Cytrill/hrdwr/3dprint-case/pic2.jpg

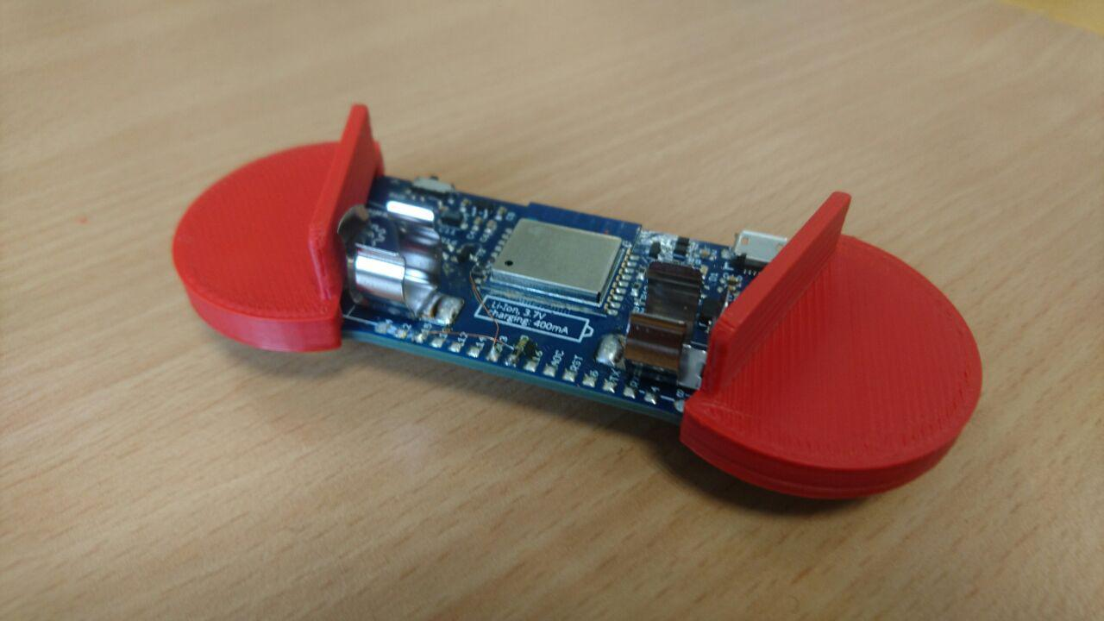
3dprint-case/pic2.jpg
