Cytrill/hrdwr/3dprint-case/pic1.jpg

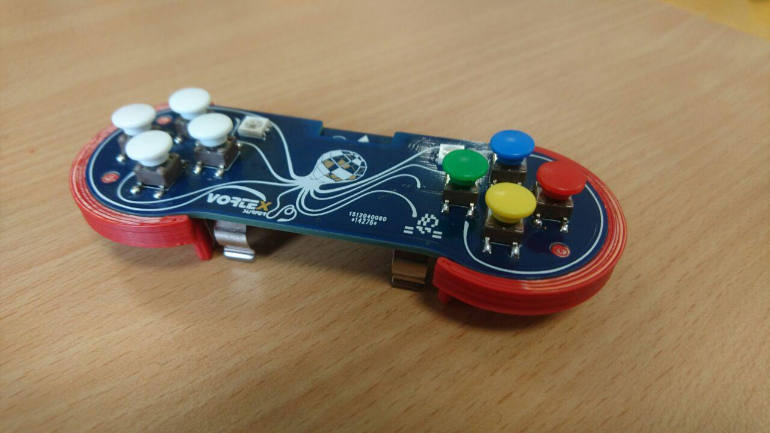
3dprint-case/pic1.jpg
