Cytrill/hrdwr/3dprint-case/readme.md

# 3D printable minimal case for Cytrill

Two 3d printable snap-on-grips. Print with the top side down and turn on support. Tested with Filamentum Extrafill ASA and works quite well after removing the support structures.

Developed in Onshape. Here is the public link (you do need a free Onshape account): https://cad.onshape.com/documents/3a4faa39f6ada6678b01b857/w/6fd7777d908e56194de24522/e/34ffa1ef84f45b661b3a6077
