Cytrill/hrdwr/3dprint-case/cytrillcase_bothhalves.stl

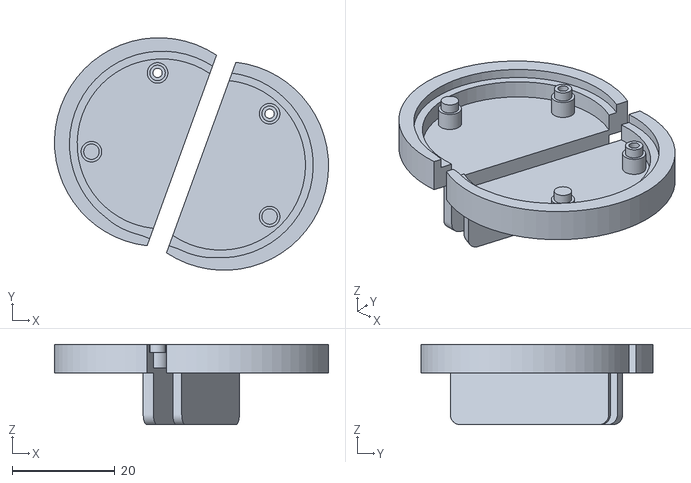
[picture p3: CAD file, 2016-03-09]
3dprint-case/cytrillcase_bothhalves.stl
53.2 x 45.1 x 15.6
