Cytrill/hrdwr/(list of files, cad)

Other CAD files:
blender-files/mockup.blend
