Cytrill/hrdwr/eagle-files/Cytrill.brd

## EAGLE design eagle-files/Cytrill.brd (2016-07-04)

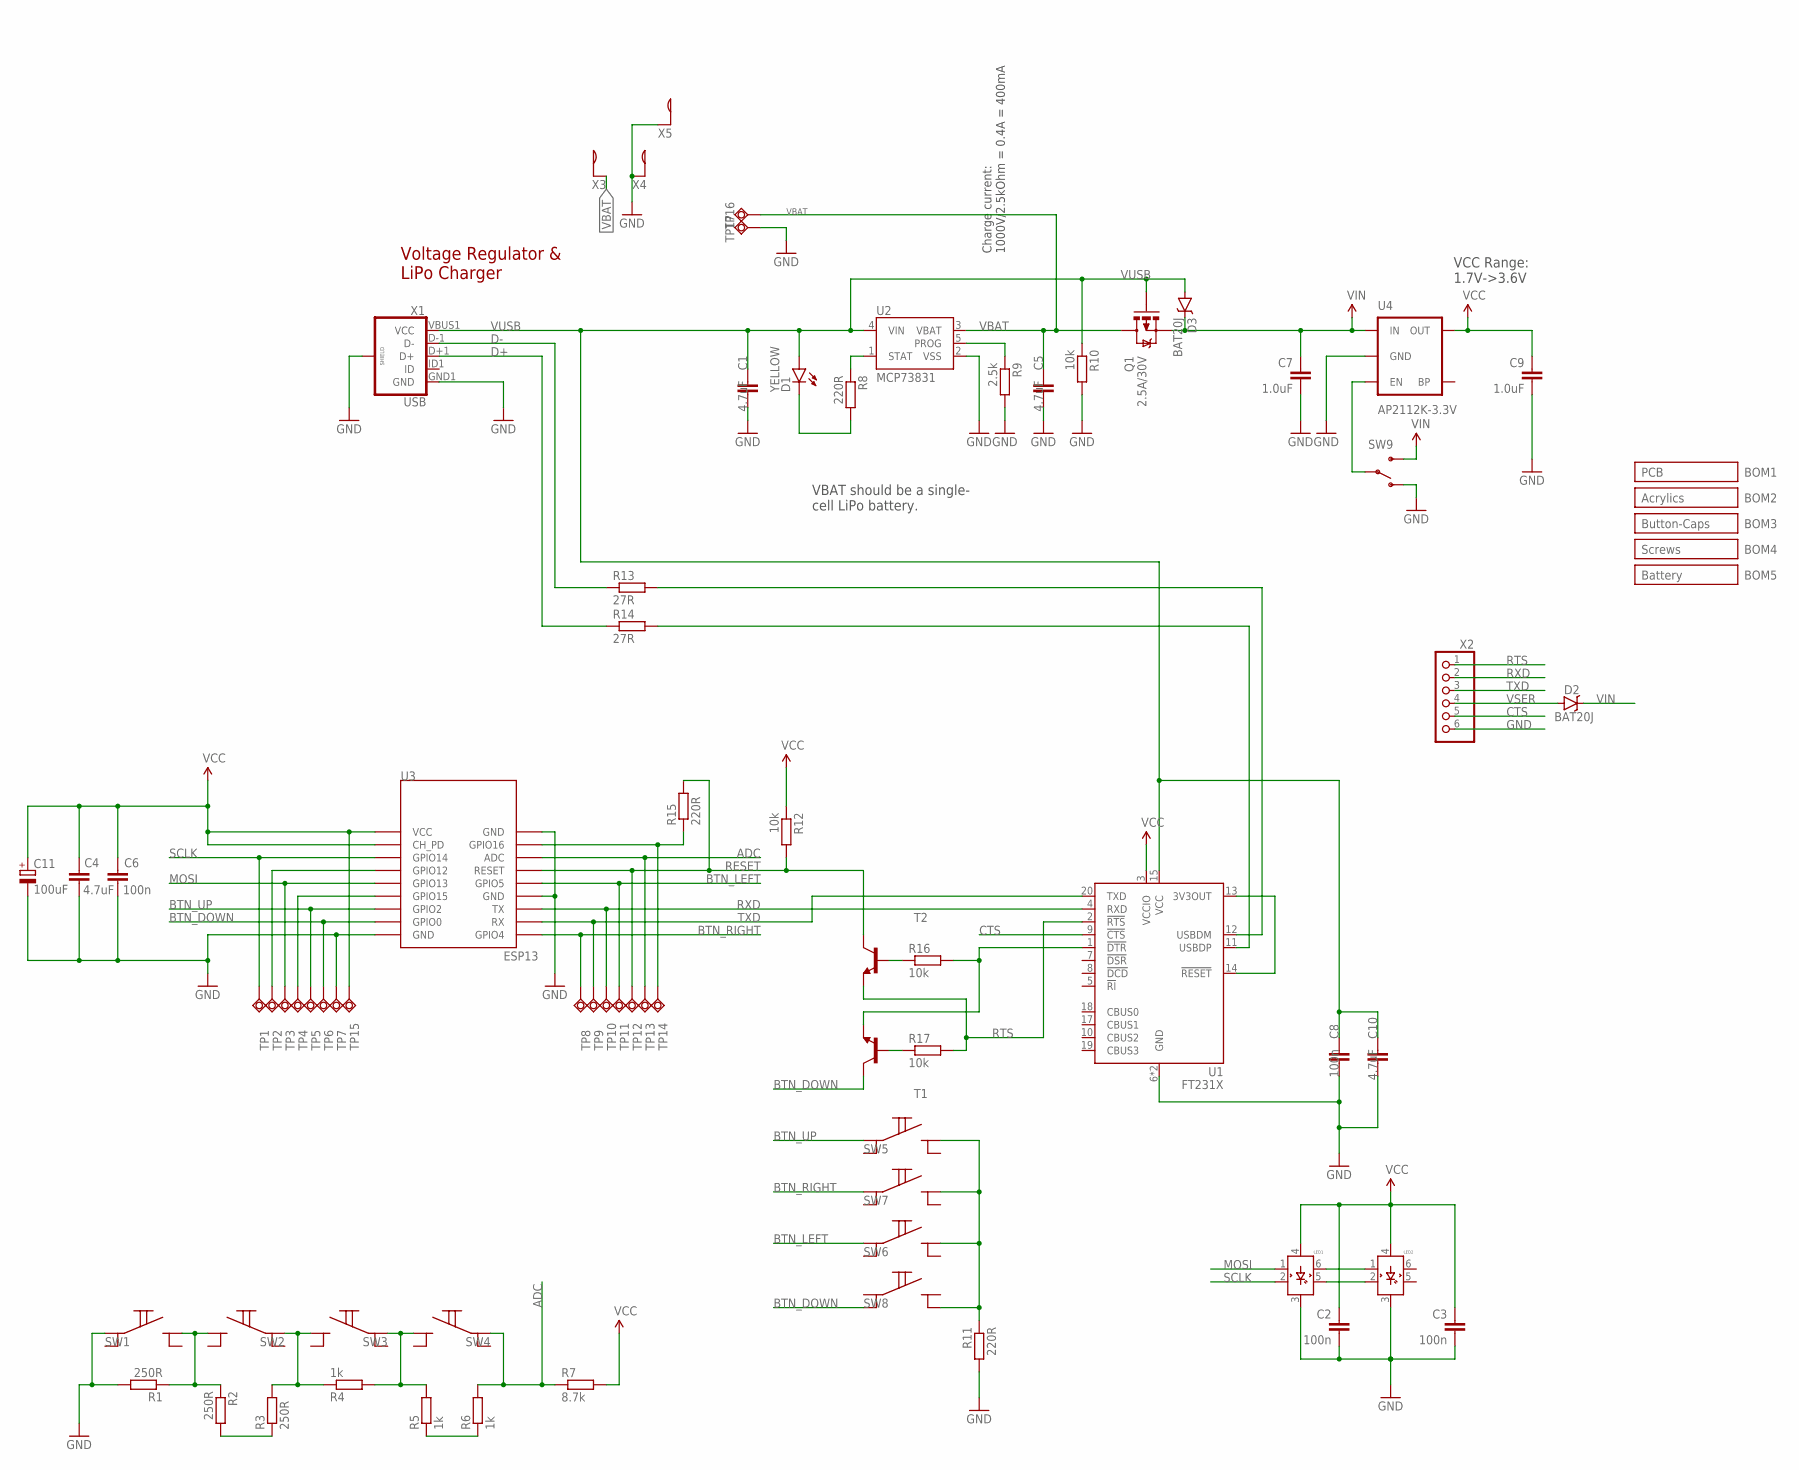
[picture p4: schematic Cytrill.sch]

Parts:
C1, C4, C5, C10: 4.7uF; C0603; PARTNO GRM188R61A475KE15D-MO
C2, C3, C6, C8: 100n; C0603; PARTNO C0603C104K4RACTU-MO
C7, C9: 1.0uF; C0603; PARTNO GRM188R61E105KA12D-MO
C11: 100uF; 3216-A; PARTNO TANTAL100UF
D1: YELLOW; LED-0603; PARTNO LYQ396P1Q236-MO
D2, D3: BAT20J; SOD-323; PARTNO BAT20JFILM-MO
LED1, LED2: APA102; RGBLED5050; PARTNO APA102
Q1: 2.5A/30V; SOT23-3; PARTNO DMP3130L-7-MO
R1, R2, R3: 250R; R0603; PARTNO ERJ3EKF2490V-MO
R4, R5, R6: 1k; R0603; PARTNO ERJ3EKF1001V-MO
R7: 8.7k; R0603; PARTNO ERJ3EKF8661V-MO
R8, R11, R15: 220R; R0603; PARTNO ERJ3EKF2200V-MO
R9: 2.5k; R0603; PARTNO ERJ3EKF2491V-MO
R10, R12, R16, R17: 10k; R0603; PARTNO ERJ3EKF1002V-MO
R13, R14: 27R; R0603; PARTNO ERJ3EKF27R0V-MO
SW1, SW2, SW3, SW4, SW5, SW6, SW7, SW8: TACTSWITCH6MM; TACTSWITCH; PARTNO 101-0364-EV-MO
SW9: SWITCH-SPDT-SMD-A; SWITCH-SPST-SMD-A; PARTNO SSSS810701
T1, T2: BC847C-NPN-SOT23-BEC; SOT23-BEC; PARTNO BC847C-MO
TP1, TP2, TP3, TP4, TP5, TP6, TP7, TP8, TP9, TP10, TP11, TP12, TP13, TP14, TP15: TPSQTP15SQ; TP15SQ; PARTNO TESTPAD
TP16, TP17: TPSQTP20R; TP20R; PARTNO TESTPAD
U1: FT231X; SSOP20; PARTNO FT231XS
U2: MCP73831; SOT23-5; PARTNO MCP73831T-2ATI/OT
U3: ESP13; PARTNO esp-13
U4: AP2112K-3.3V; SOT23-5; PARTNO AP2112K-3.3
X1: USB; USB-B-MICRO-SMD_V03
X2: PINHD-1X6/90-SMD; 1X06/90-SMD; PARTNO 961106-5500-AR-PR-MO
X3, X4, X5: BATTERYTERMINAL; KEYSTONE-55; PARTNO KS55-MO

Connections:
ADC: R6.2, R7.1, SW4.A@1 (A), TP13.TP, U3.ADC
BTN_DOWN: SW8.A@2 (A1), T1.3 (C), TP6.TP, U3.GPIO0
BTN_LEFT: SW6.A@1 (A), TP11.TP, U3.GPIO5
BTN_RIGHT: SW7.A@1 (A), TP8.TP, U3.GPIO4
BTN_UP: SW5.A@1 (A), TP5.TP, U3.GPIO2
CTS: U1.9 (!CTS), X2.5
D+: R14.1, X1.D+1 (D+)
D-: R13.1, X1.D-1 (D-)
GND: C1.2, C2.2, C3.2, C4.2, C5.2, C6.2, C7.2, C8.2, C9.2, C10.2, C11.-, LED1.3 (GND), LED2.3 (GND), R1.2, R9.2, R10.2, R11.2, SW1.A@1 (A), SW9.1 (O), TP7.TP, TP17.TP, U1.6 (GND), U1.16 (GND), U2.2 (VSS), U3.GND@0 (GND), U3.GND@1 (GND), U3.GND@2 (GND), U4.2 (GND), X1.GND1 (GND), X1.SHIELD1 (SHIELD), X1.SHIELD2 (SHIELD), X2.6, X4.1@1, X4.1@2, X5.1@1, X5.1@2
MOSI: LED1.1 (DIN), TP3.TP, U3.GPIO13
unnamed: LED1.6 (DOUT), LED2.1 (DIN)
unnamed: LED1.5 (COUT), LED2.2 (CIN)
unnamed: R11.1, SW5.B@1 (B), SW6.B@1 (B), SW7.B@1 (B), SW8.B@2 (B1)
unnamed: R14.2, U1.11 (USBDP)
unnamed: R15.1, TP14.TP, U3.GPIO16
unnamed: R1.1, R2.1, SW1.B@1 (B), SW2.B@1 (B)
unnamed: R3.2, R4.1, SW2.A@1 (A), SW3.B@1 (B)
unnamed: R4.2, R5.2, SW3.A@1 (A), SW4.B@1 (B)
unnamed: R13.2, U1.12 (USBDM)
unnamed: U1.13 (3V3OUT), U1.14 (!RESET)
unnamed: SW9.2, U4.3 (EN)
unnamed: R16.1, T2.1 (B)
unnamed: R5.1, R6.1
unnamed: R9.1, U2.5 (PROG)
unnamed: R2.2, R3.1
unnamed: TP2.TP, U3.GPIO12
unnamed: D1.C, R8.2
unnamed: R8.1, U2.1 (STAT)
unnamed: TP4.TP, U3.GPIO15
unnamed: R17.1, T1.1 (B)
unnamed: R16.2, T1.2 (E), U1.1 (!DTR)
RESET: R12.2, R15.2, T2.3 (C), TP12.TP, U3.RST (RESET)
RTS: R17.2, T2.2 (E), U1.2 (!RTS), X2.1
RXD: TP10.TP, U1.4 (RXD), U3.TXD (TX), X2.2
SCLK: LED1.2 (CIN), TP1.TP, U3.GPIO14
TXD: TP9.TP, U1.20 (TXD), U3.RXD (RX), X2.3
VBAT: C5.1, Q1.3 (D), TP16.TP, U2.3 (VBAT), X3.1@1, X3.1@2
VCC: C2.1, C3.1, C4.1, C6.1, C9.1, C11.+, LED1.4 (VDD), LED2.4 (VDD), R7.2, R12.1, TP15.TP, U1.3 (VCCIO), U3.CH_PD, U3.VCC, U4.5 (OUT)
VIN: C7.1, D2.C, D3.C, Q1.2 (S), SW9.3 (S), U4.1 (IN)
VSER: D2.A, X2.4
VUSB: C1.1, C8.1, C10.1, D1.A, D3.A, Q1.1 (G), R10.1, U1.15 (VCC), U2.4 (VIN), X1.VBUS1 (VCC)

Notes on the sheet:
Voltage Regulator & LiPo Charger
VCC Range: 1.7V->3.6V
VBAT should be a single- cell LiPo battery.
Charge current: 1000V/2.5kOhm = 0.4A = 400mA

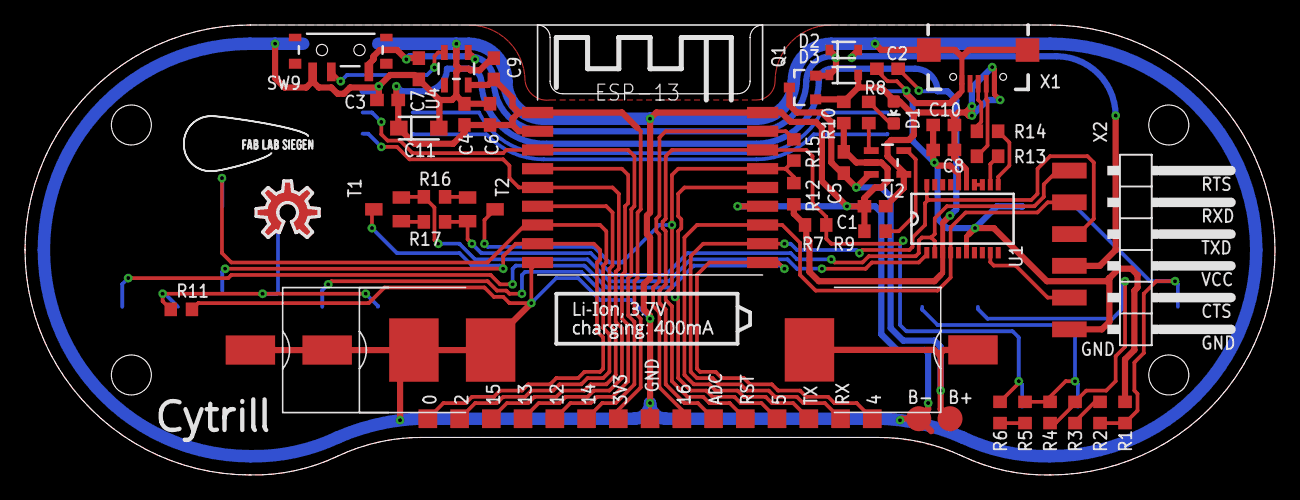
[picture p5: board Cytrill.brd from above]

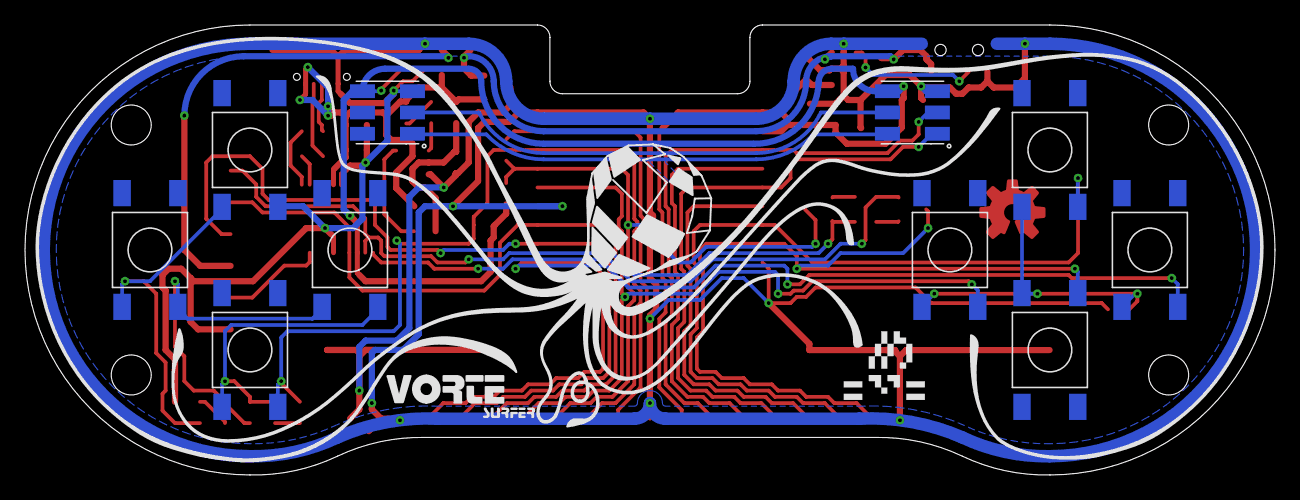
[picture p6: board Cytrill.brd from below]

Board: 2 copper layers, 100.0 x 36.0 mm, 77 parts (13 on the bottom side), 41 nets.

Other parts of the board:
U$1: FABLAB-KLEIN
U$2: SIMON-LOGO
U$3: HASII
U$4: VORTEX-KLEIN.1
U$5: OSHWLOGO_TOP_0.2
U$6: OCTO
