Cytrill/hrdwr/(threads)

Thread 1 (2016-07-03):

EagleCAD Dateien

Quantum113, 2016-07-03:
Wäre ganz schön die EagleCAD-Dateien öffentlich zu machen. So könnte ich vielleicht ein paar zum Testen von Spieleentwürfen produzieren lassen.

misterdanb, 2016-07-03:
Habe das mal in entsprechende Personen weiterkommuniziert. Steht eigenltich schon länger auf der Agenda, aber irgendwie haben wir das immer wieder verschludert.

simon-budig, 2016-07-04:
Ich habe da mal was gepusht...

Quantum113, 2016-07-06:
Vielen Dank

misterdanb, 2016-07-06:
Aber schau nochmal drüber, die Version ist vielleicht noch fehlerhaft, es fehlten in der unserer produzierten Version nämlich noch ein paar Vorwiderstände.

Closed 2016-07-04.
