Cytrill/hrdwr/(commit log)

2015-08-25 added blender 3d mockup
    [mockup.blend]
2016-03-09 3d printed case initial commit
    [cytrillcase_bothhalves.stl]
2016-07-04 Eagle files for Cytrill. Slightly more refined compared to the 1st run of PCBs
    [Cytrill.brd, Cytrill.sch, parts-db.csv]
